John-Alves/low-cost-potentiostat/README.md

# Potenciostato de Baixo Custo

Projeto de um potenciostato de baixo custo para uso em laboratórios de eletroquímica (incialmente baseado em arduino).

Etapas do projeto:

- __1ª Etapa__: Construir o mesmo projeto do artigo: Building a Microcontroller based potentiostat.
- __2ª Etapa__: Implementar outras técnicas essenciais para o funcionamento do produto.
- __3ª Etapa__: Tirar o circuito da protoboard e montar um MVP.
- __4ª Etapa__: Criar GUI própria e mostrar os resultados em forma de gráfico por ela. (talvez uma interface web)

## Referências

> As referências para esse projeto se encontram dentro da pasta `artigos_e_links`.
