John-Alves/low-cost-potentiostat/artigos_e_links/links.md

# Lista de Links utéis:



1. Explicacao sobre potenciostato e o circuito: https://publiclab.org/wiki/potentiostat

2. How-To de como construir um potenciostato (teensyduino): http://2014.igem.org/Team:UC_Davis/Potentiostat_Design_Get_Started

3. Artigo - "Building a Microcontroller Based Potentiostat: A Inexpensive and Versatile Platform for Teaching Electrochemistry and Instrumentation"<br>https://pubs.acs.org/doi/10.1021/acs.jchemed.5b00961
