John-Alves/low-cost-potentiostat/simulacao/versao 0.0/esquematico_montado.PDF

U1:A

R2

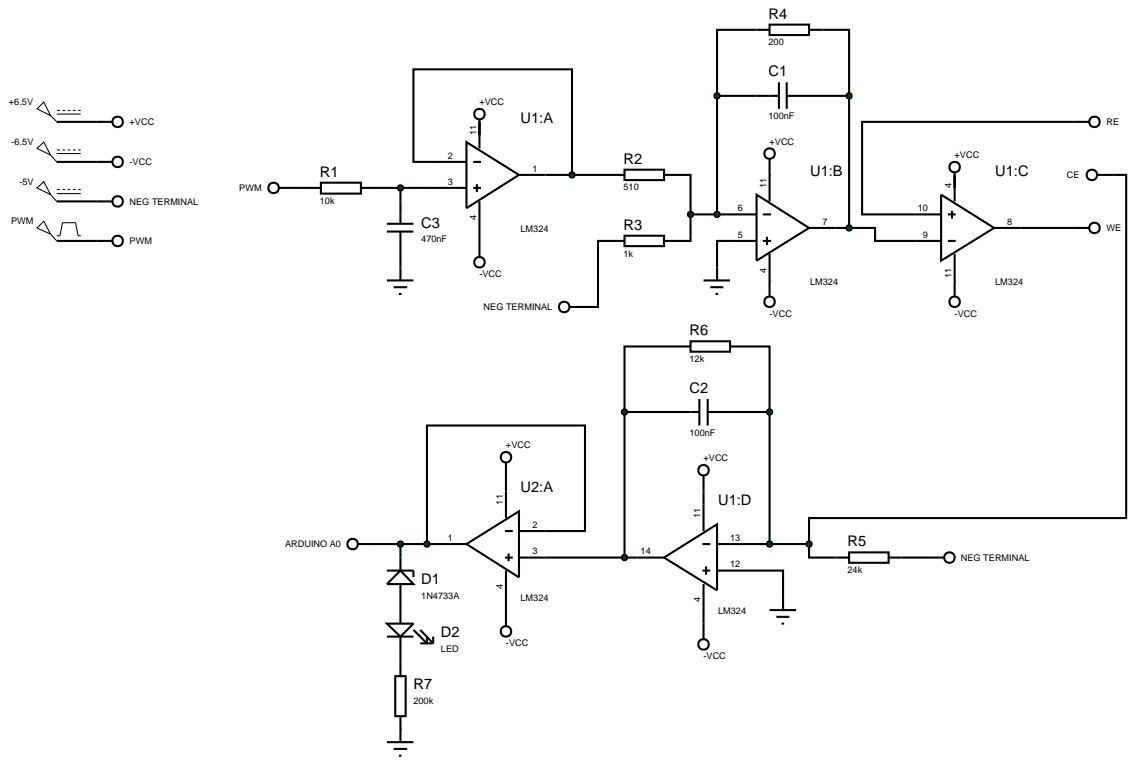
[picture p40: page 1]
