John-Alves/low-cost-potentiostat/(list of files, drawings)

Other design files:
simulacao/versao 0.0/esquematico.pdsprj
